UANL-CA-170/TAKE-HOME-LABS/pcb_src/2 FDI-UI-&-PLANTS/M1/documents.pdf

A | A
B | B

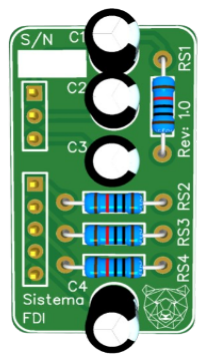
[picture p2: figure]
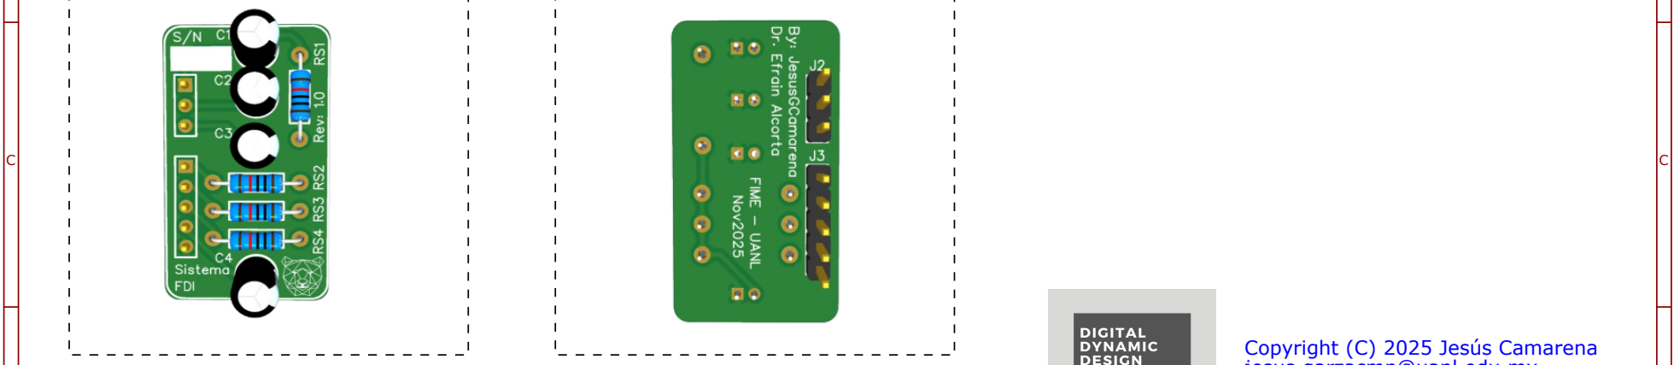
[picture p3: figure]
Copyright (C) 2025 Jesús Camarena

D | D

1

2

3

4

5

TITLE:
COVER PAGE | REV: 1.0
Date: | 15/11/25 Sheet: 1/7
| Drawn By: JesusGCamarena

Company: UANL - FIME

# Sistema FDI

COVER PAGE | DATE: 15/11/2025 V1.0

jesus.garzacmn@uanl.edu.mx Este documento es Open Hardware Licencia: CERN-OHL-S
https://cern-ohl.web.cern.ch/home

3.

2.

# 1. COVER PAGE

# Page Index

4.
MAIN | 5.
LAYOUT | 6.

# MECHANICAL

9.

8.

# 7. REVISION HISTORY

IndexPage | IndexPage

WARNING NOTE:
Example text for a critical design note

LAYOUT NOTE:
Example text for a informational layout guidelines note

Example text for a cautionary design note

CAUTION NOTE:

Example text for a informational design note

INFO NOTE:

TOP PCB VIEW | BOTTOM PCB VIEW 3D MODEL

# PANELIZE BOARD

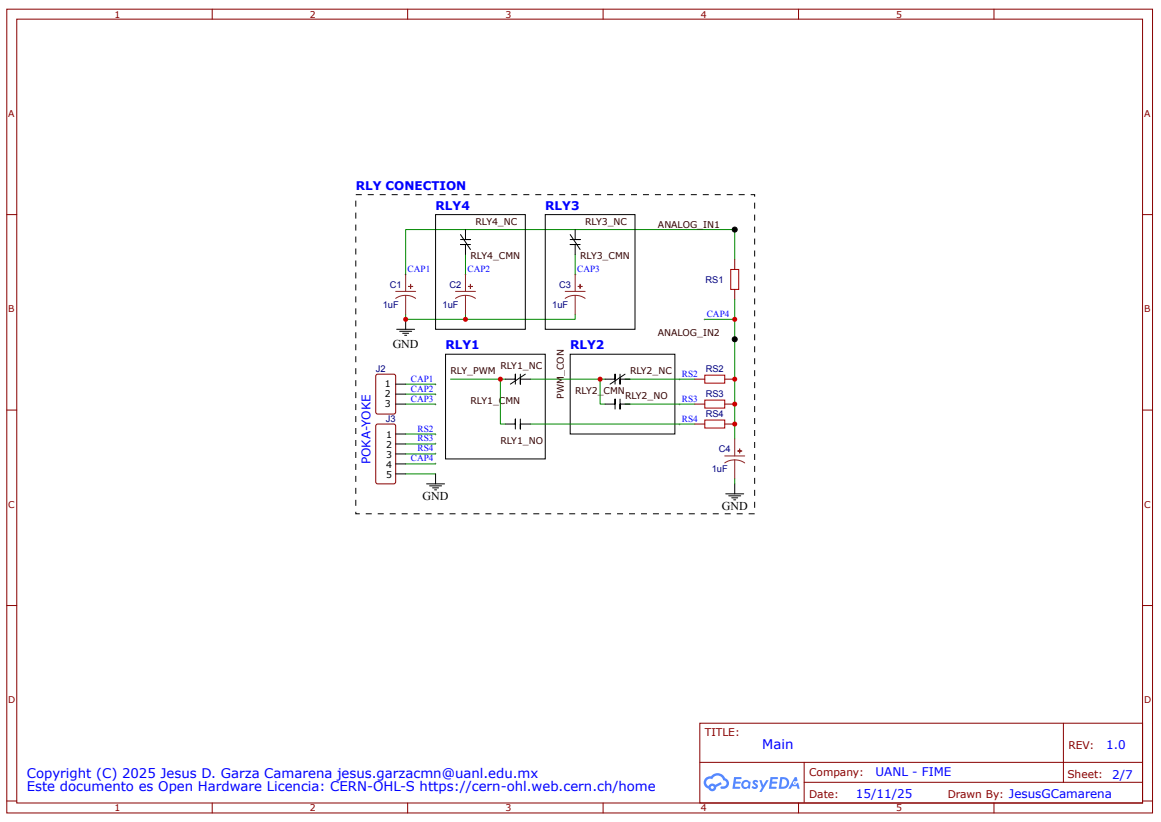
[picture p4: page 2]
TITLE:; Main; REV: 1.0; Date:; Sheet: 2/7; RLY4_NC; RLY4_CMN; RLY3_CMN; RLY3_NC; RLY2_NC; RLY2_CMNRLY2_NO; RLY1_NO; RLY1_NC; RLY1_CMN; CAP2; CAP3; CAP1; GND; CAP4; RLY CONECTION; RLY4; RLY3; RLY1; RLY2; RLY_PWM; PWM_CON; ANALOG_IN2; ANALOG_IN1; POKA-YOKE

Copyright (C) 2025 Jesus D. Garza Camarena jesus.garzacmn@uanl.edu.mx
Este documento es Open Hardware Licencia: CERN-OHL-S https://cern-ohl.web.cern.ch/home

Company: UANL - FIME

Drawn By: JesusGCamarena

# LAYOUT

TOP COPPER | BOTTOM VIEW

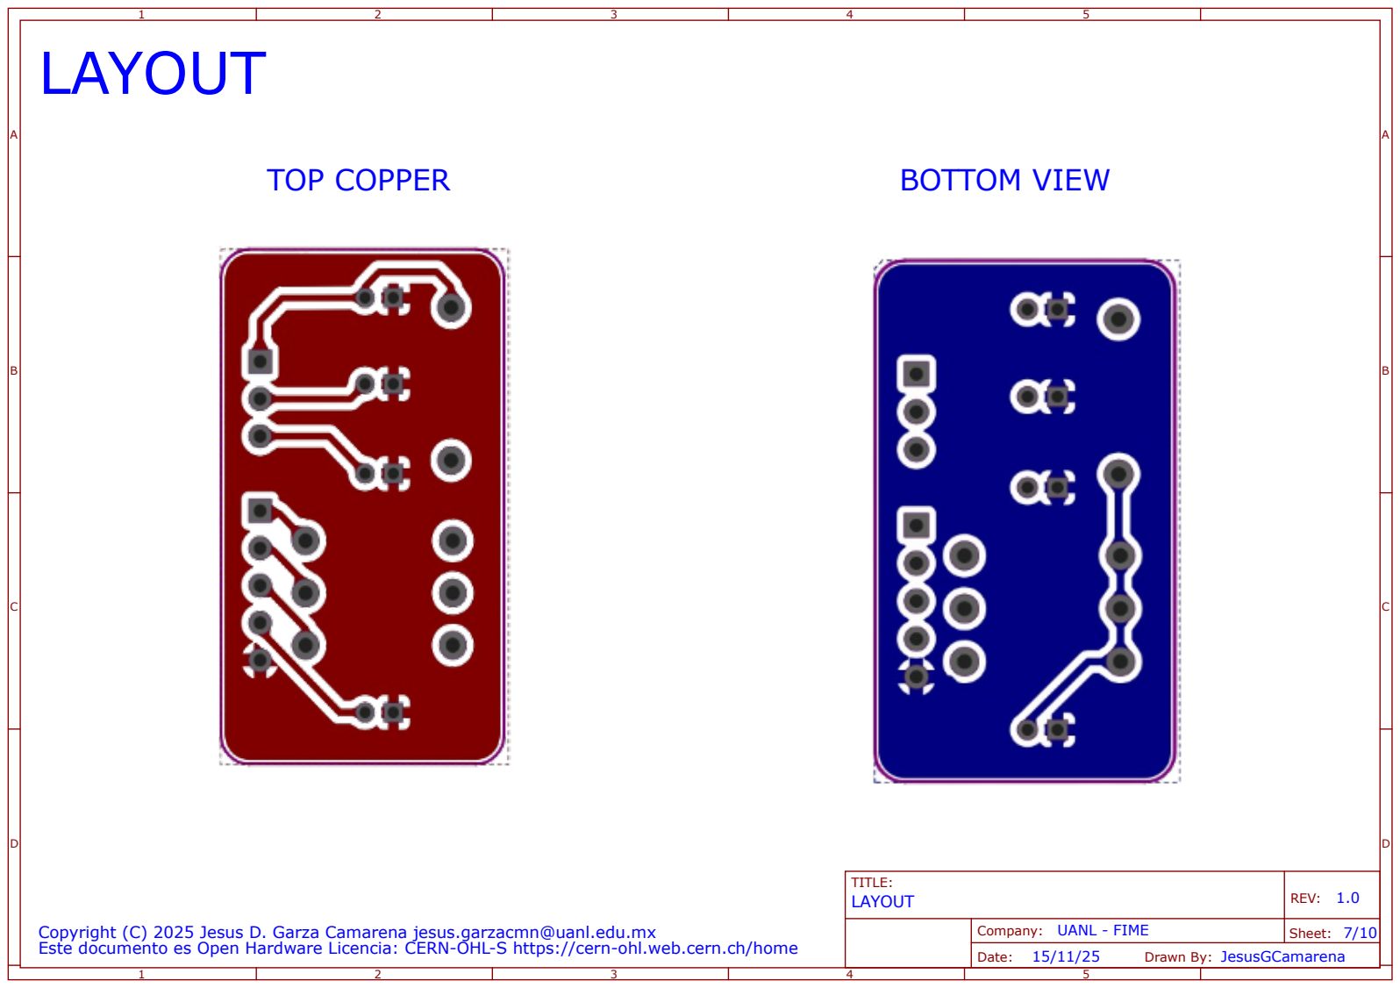
[picture p5: page 3]

A | A
B | B
C | C
D | D

1

2

3

4

5

TITLE:
LAYOUT | REV: 1.0

Date:

Sheet: 7/10
Drawn By:

Company: UANL - FIME
Copyright (C) 2025 Jesus D. Garza Camarena jesus.garzacmn@uanl.edu.mx
Este documento es Open Hardware Licencia: CERN-OHL-S https://cern-ohl.web.cern.ch/home | 15/11/25 | JesusGCamarena

A | A

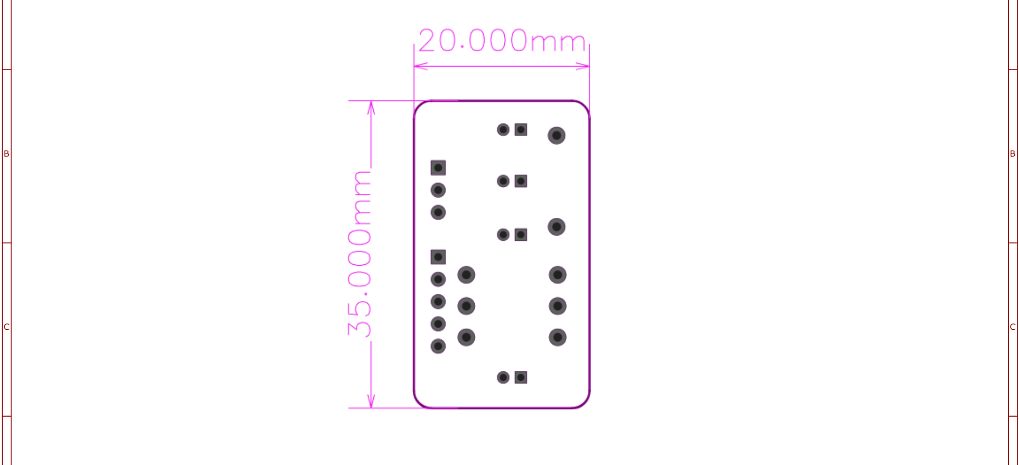
[picture p6: figure]

D | D

1

2

3

4

5

TITLE:
MECHANICAL | REV: 1.0

Date:

Sheet: 8/10
Drawn By:

Company: UANL - FIME

# Mechanical

Copyright (C) 2025 Jesus D. Garza Camarena jesus.garzacmn@uanl.edu.mx
Este documento es Open Hardware Licencia: CERN-OHL-S https://cern-ohl.web.cern.ch/home | 15/11/25 | JesusGCamarena

# PANELIZE BOARD

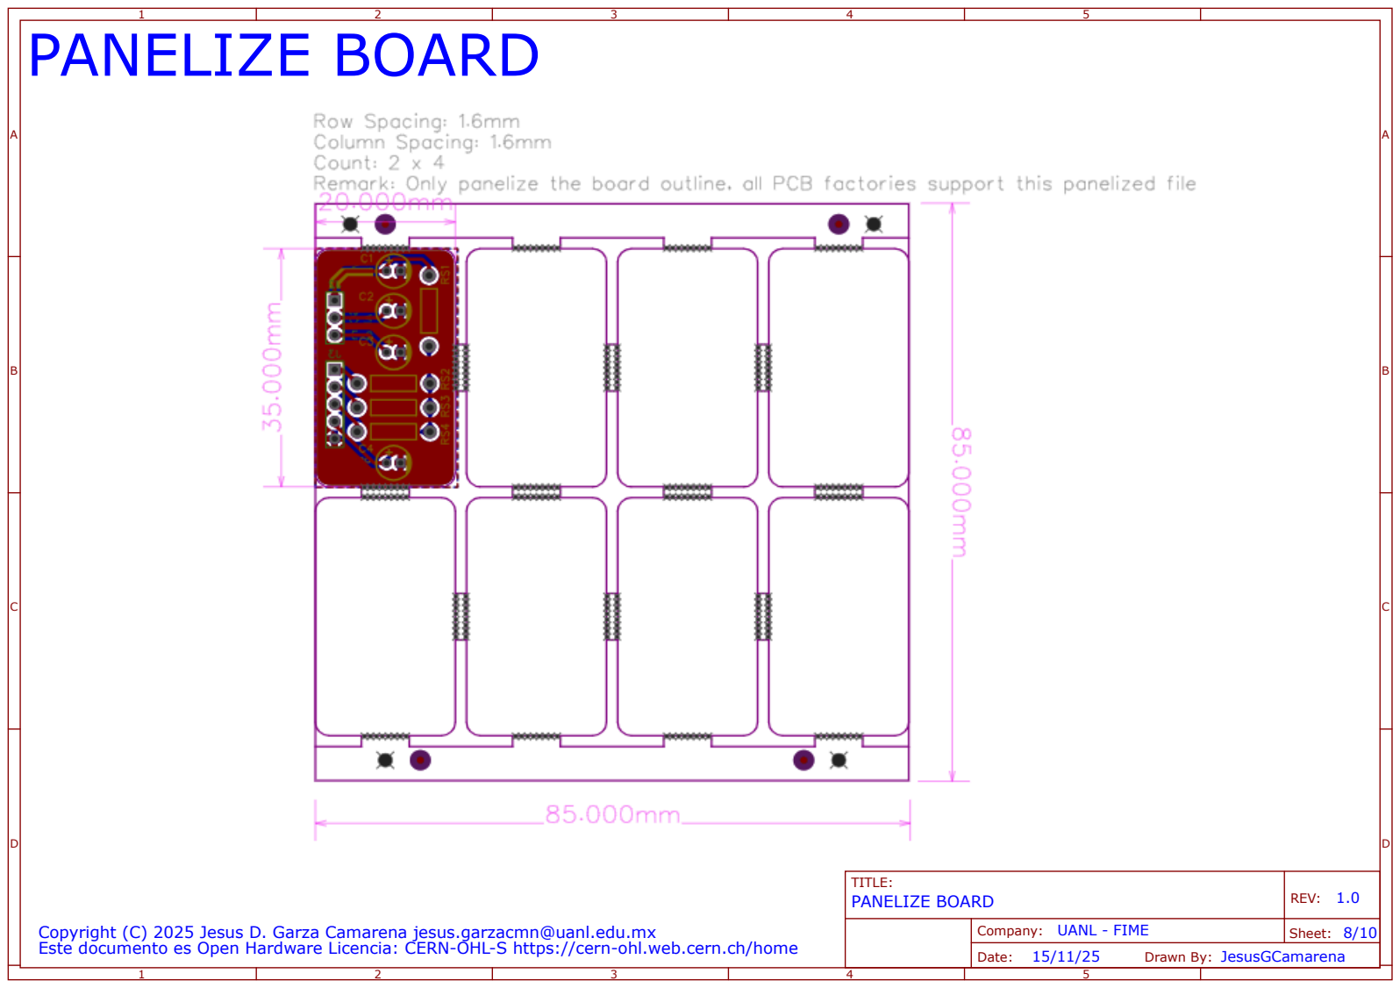
[picture p7: page 5]

A | A
B | B
C | C
D | D

1

2

3

4

5

TITLE:
PANELIZE BOARD | REV: 1.0

Date:

Sheet: 8/10
Drawn By:

Company: UANL - FIME
Copyright (C) 2025 Jesus D. Garza Camarena jesus.garzacmn@uanl.edu.mx
Este documento es Open Hardware Licencia: CERN-OHL-S https://cern-ohl.web.cern.ch/home | 15/11/25 | JesusGCamarena

# 3D MODEL

TOP PCB VIEW | BOTTOM PCB VIEW

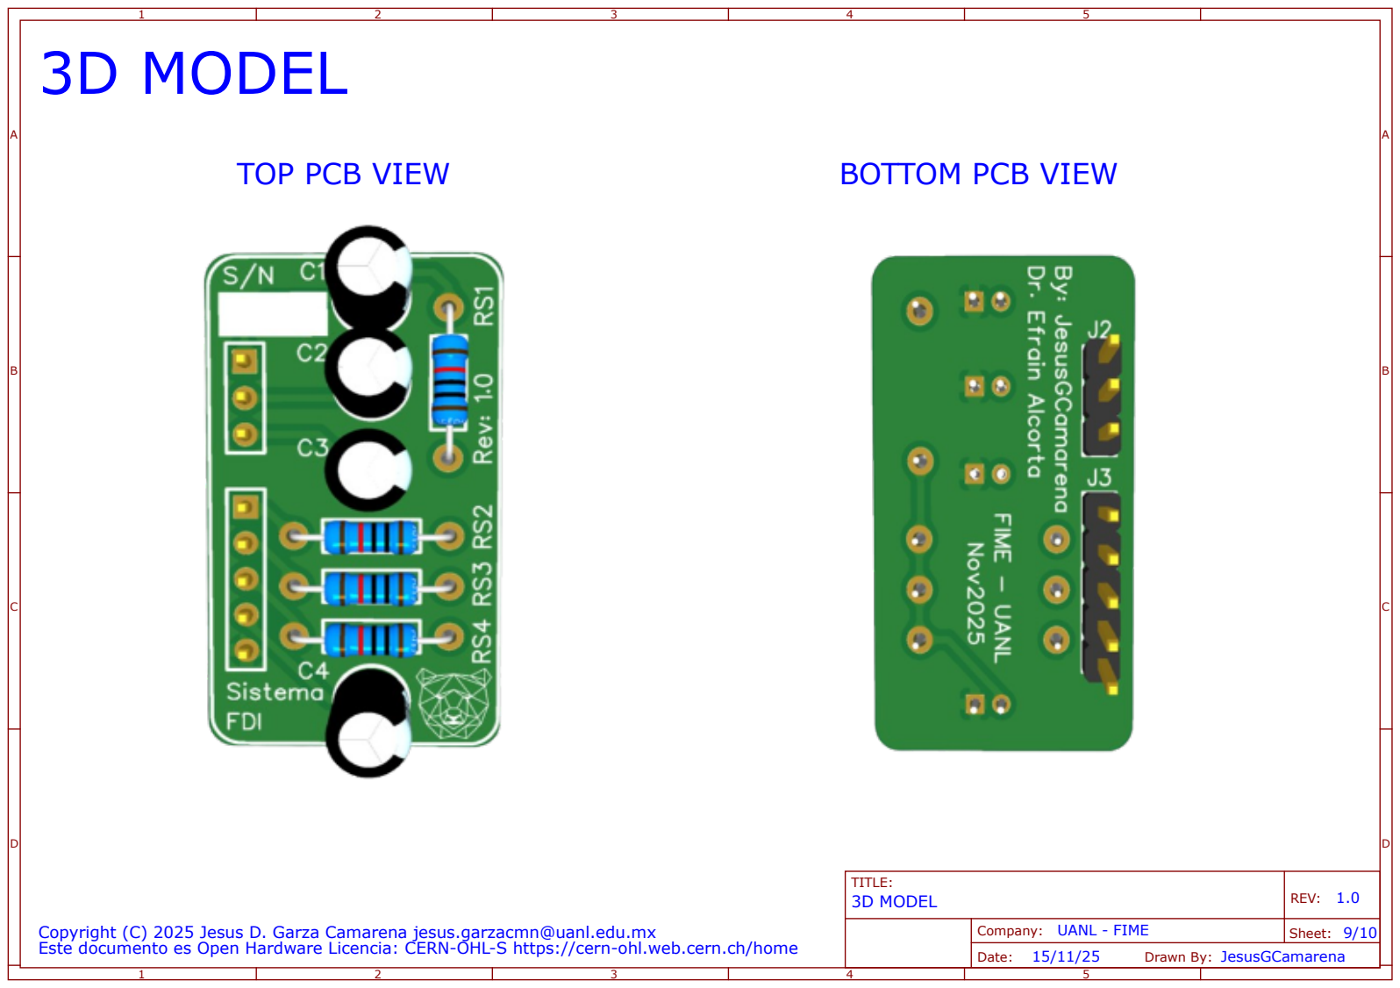
[picture p8: page 6]

A | A
B | B
C | C
D | D

1

2

3

4

5

TITLE:
3D MODEL | REV: 1.0

Date:

Sheet: 9/10
Drawn By:

Company: UANL - FIME
Copyright (C) 2025 Jesus D. Garza Camarena jesus.garzacmn@uanl.edu.mx
Este documento es Open Hardware Licencia: CERN-OHL-S https://cern-ohl.web.cern.ch/home | 15/11/25 | JesusGCamarena

A | A
B | B
C | C
D | D

1

2

3

4

5

TITLE:
REVISION HISTORY | REV: 1.0

Date:

Sheet:10/10
Drawn By:

Company: UANL - FIME

# N° Revision/Issue: Date:

# REVISION HISTORY

Copyright (C) 2025 Jesus D. Garza Camarena jesus.garzacmn@uanl.edu.mx
Este documento es Open Hardware Licencia: CERN-OHL-S https://cern-ohl.web.cern.ch/home
Initial Design | 11/11/25
15/11/25 | JesusGCamarena
