UANL-CA-170/TAKE-HOME-LABS/pcb_src/2 FDI-UI-&-PLANTS/UI/documents.pdf

A | A
B | B

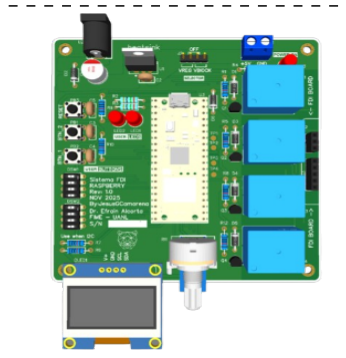
[picture p9: figure]
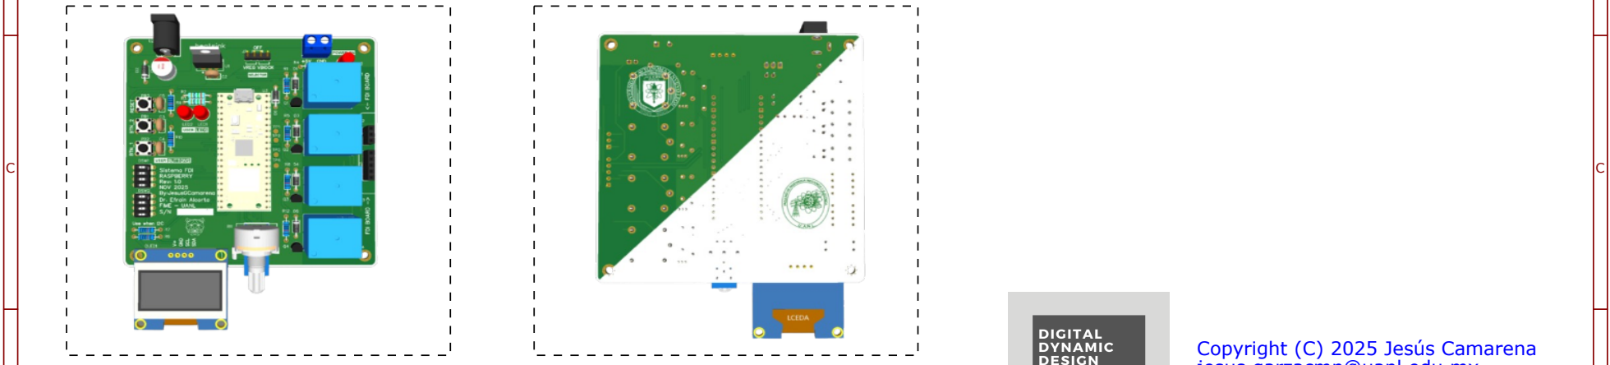
[picture p10: figure]
Copyright (C) 2025 Jesús Camarena

D | D

1

2

3

4

5

TITLE:
COVER PAGE | REV: 1.1
Date: | 15/11/25 Sheet: 1/10
| Drawn By: JesusGCamarena

Company: UANL - FIME

# Sistema Embebido RaspBerry

COVER PAGE | DATE: 15/11/2025 V1.0

jesus.garzacmn@uanl.edu.mx Este documento es Open Hardware Licencia: CERN-OHL-S
https://cern-ohl.web.cern.ch/home

3.

2.

1.

# BLOCK DIAGRAM

# COVER PAGE

# PIN LIST

# Page Index

4.
MAIN5.

# LAYOUT

6.

# MECHANICAL

9.

8.

7.

# REVISION HISTORY

IndexPage | IndexPage

WARNING NOTE:
Example text for a critical design note

LAYOUT NOTE:
Example text for a informational layout guidelines note

Example text for a cautionary design note

CAUTION NOTE:

Example text for a informational design note

INFO NOTE:

TOP PCB VIEW | BOTTOM PCB VIEW

10.

# 3D MODEL

# PIN OUT

# ORIGINAL

# BLOCK DIAGRAM

## POWER SOURCE

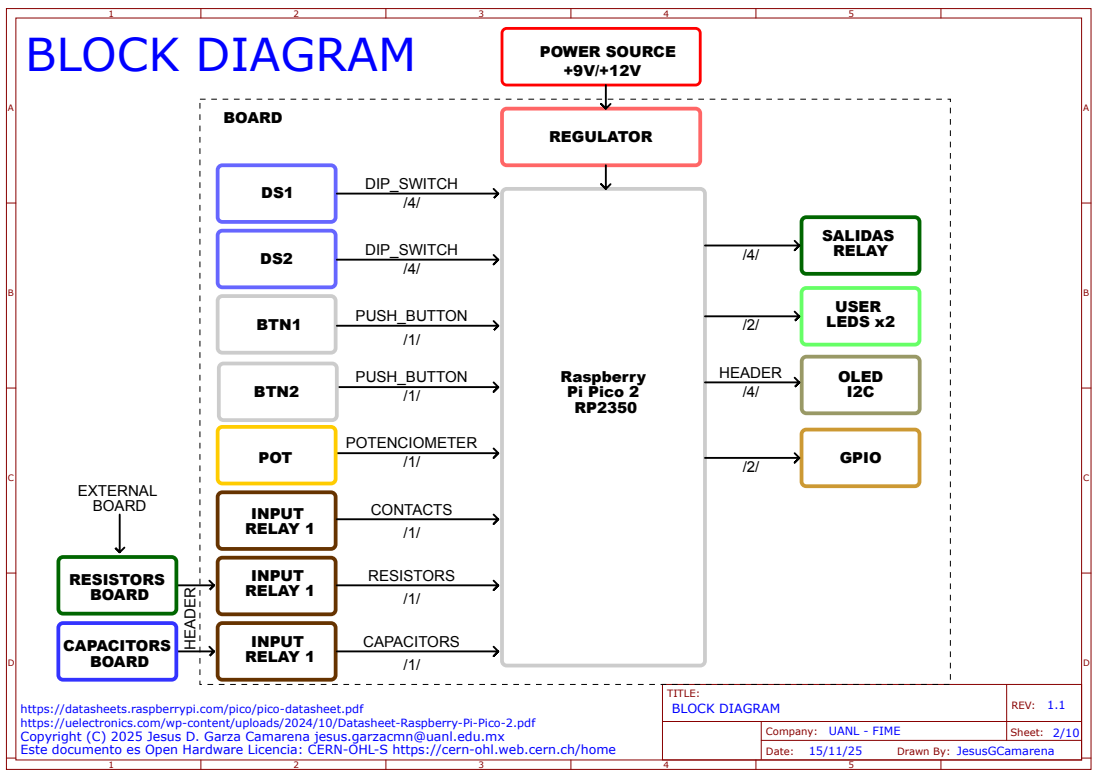
[picture p11: page 2]
TITLE:; BLOCK DIAGRAM; REV: 1.1; Sheet: 2/10; Drawn By:; REGULATOR; SALIDAS RELAY; GPIO; Raspberry Pi Pico 2 RP2350; BOARD; POT; INPUT RELAY 1; DIP_SWITCH; OLED I2C; PUSH_BUTTON; POTENCIOMETER; CONTACTS; HEADER; DIP_SWITCH /4/; BTN1; BTN2; PUSH_BUTTON /1/; USER; LEDS x2; INPUT; RESISTORS; RELAY 1; CAPACITORS; RESISTORS BOARD; CAPACITORS BOARD; EXTERNAL BOARD; JesusGCamarena

https://datasheets.raspberrypi.com/pico/pico-datasheet.pdf
https://uelectronics.com/wp-content/uploads/2024/10/Datasheet-Raspberry-Pi-Pico-2.pdf
Copyright (C) 2025 Jesus D. Garza Camarena jesus.garzacmn@uanl.edu.mx
Este documento es Open Hardware Licencia: CERN-OHL-S https://cern-ohl.web.cern.ch/home

Company: UANL - FIME
Date:

## RLY1

## RLY2

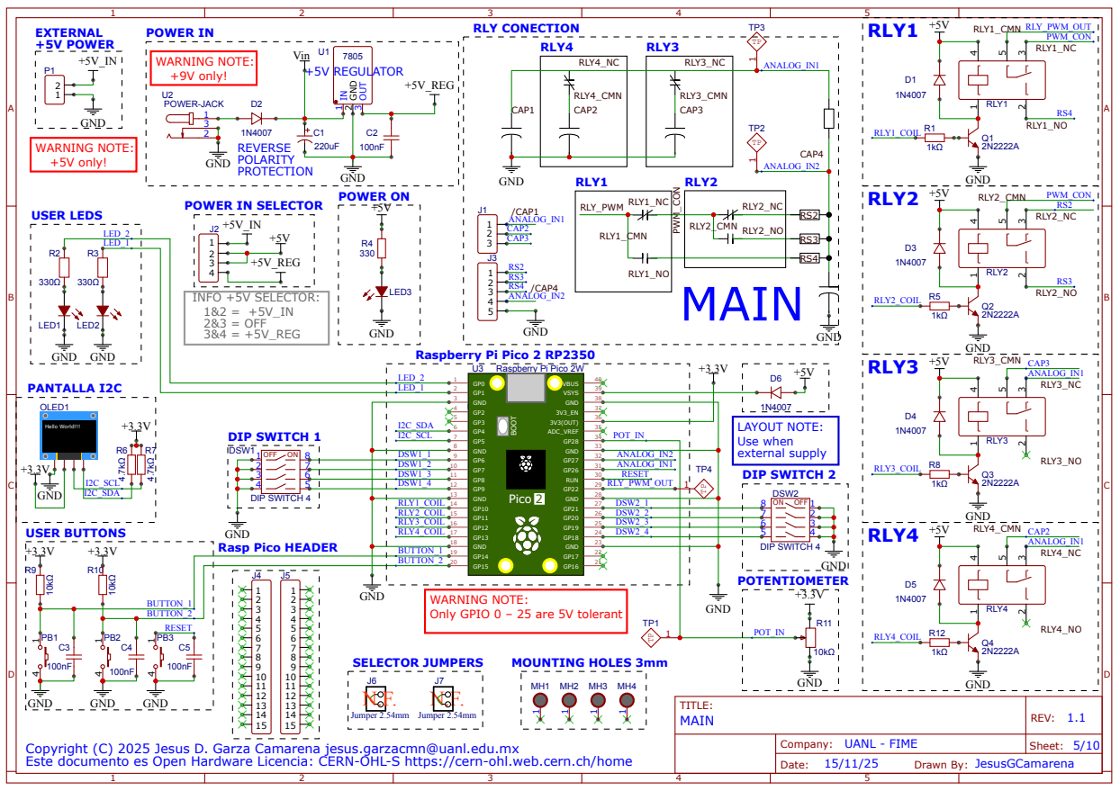
[picture p12: page 3]

WARNING NOTE:
Only GPIO 0 – 25 are 5V tolerant

Copyright (C) 2025 Jesus D. Garza Camarena jesus.garzacmn@uanl.edu.mx
Este documento es Open Hardware Licencia: CERN-OHL-S https://cern-ohl.web.cern.ch/home

# ORIGINAL LAYOUT

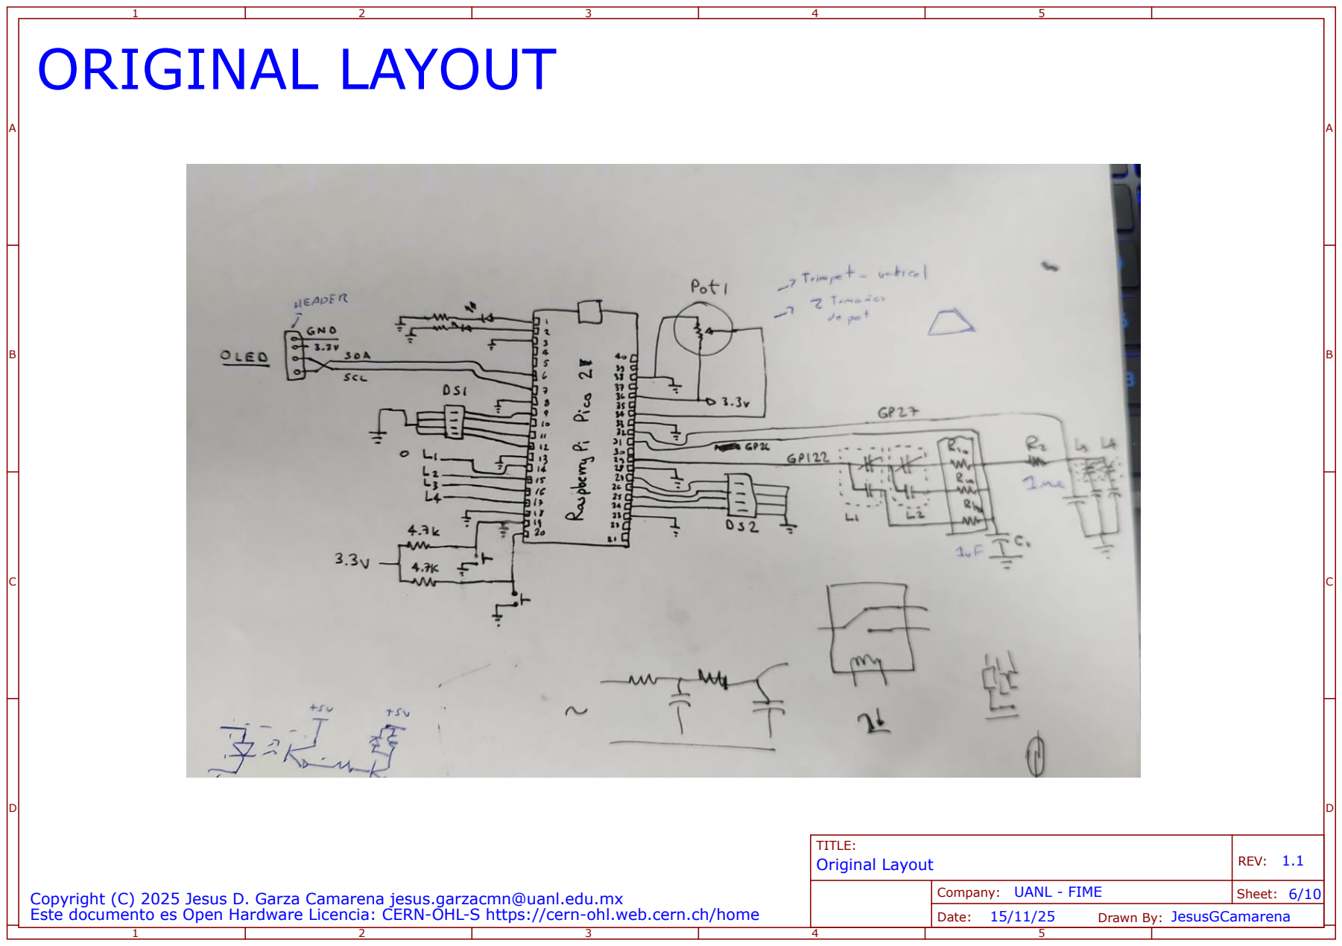
[picture p13: page 4]

A | A
B | B
C | C
D | D

1

2

3

4

5

TITLE:
Original Layout | REV: 1.1

Date:

Sheet: 6/10
Drawn By:

Company: UANL - FIME
Copyright (C) 2025 Jesus D. Garza Camarena jesus.garzacmn@uanl.edu.mx
Este documento es Open Hardware Licencia: CERN-OHL-S https://cern-ohl.web.cern.ch/home | 15/11/25 | JesusGCamarena

A | A
B | B
C | C
D | D

1

2

3

4

5

TITLE:
REVISION HISTORY | REV: 1.1

Date:

Sheet:10/10
Drawn By:

Company: UANL - FIME

# N° Revision/Issue: Date:

# REVISION HISTORY

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

Conexiones de la fuente VSYS y VBUS Conexiones RLY3 y RLY4
Pines que soportan +5V
Initial Design | 04/07/25
| 28/10/25 28/10/25
| 28/10/25
First Relase | 15/11/25
15/11/25 | JesusGCamarena

# LAYOUT

TOP COPPER | BOTTOM VIEW

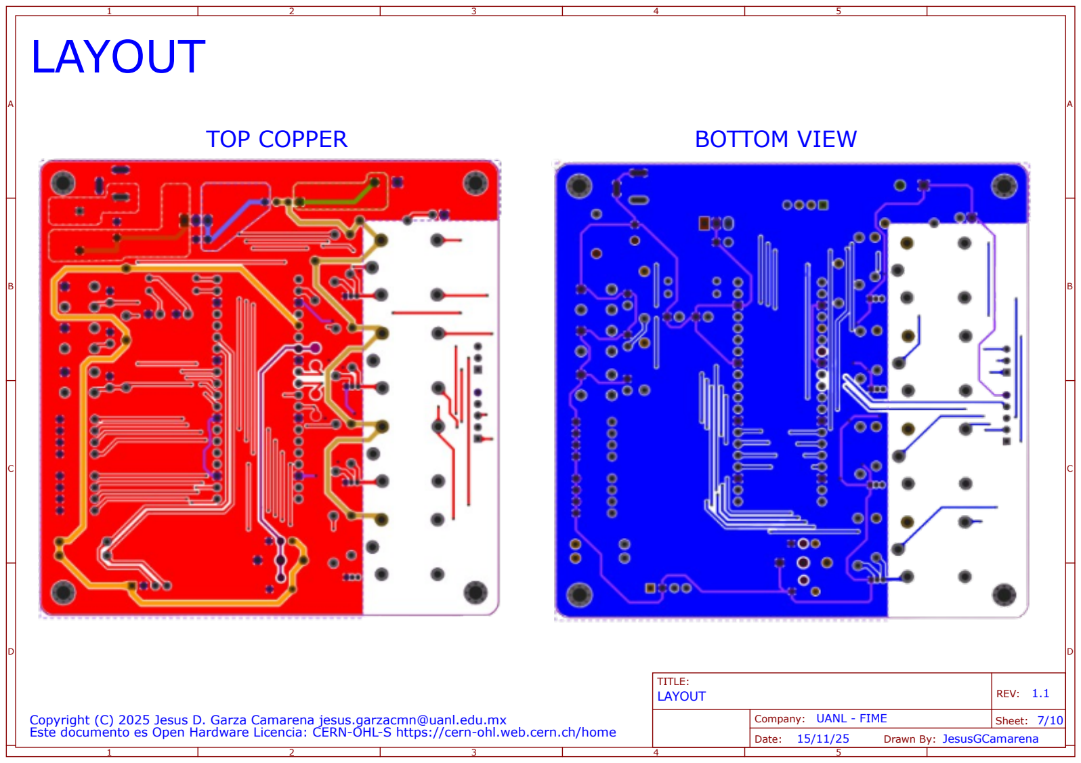
[picture p14: page 6]

A | A
B | B
C | C
D | D

1

2

3

4

5

TITLE:
LAYOUT | REV: 1.1

Date:

Sheet: 7/10
Drawn By:

Company: UANL - FIME
Copyright (C) 2025 Jesus D. Garza Camarena jesus.garzacmn@uanl.edu.mx
Este documento es Open Hardware Licencia: CERN-OHL-S https://cern-ohl.web.cern.ch/home | 15/11/25 | JesusGCamarena

# PIN LIST

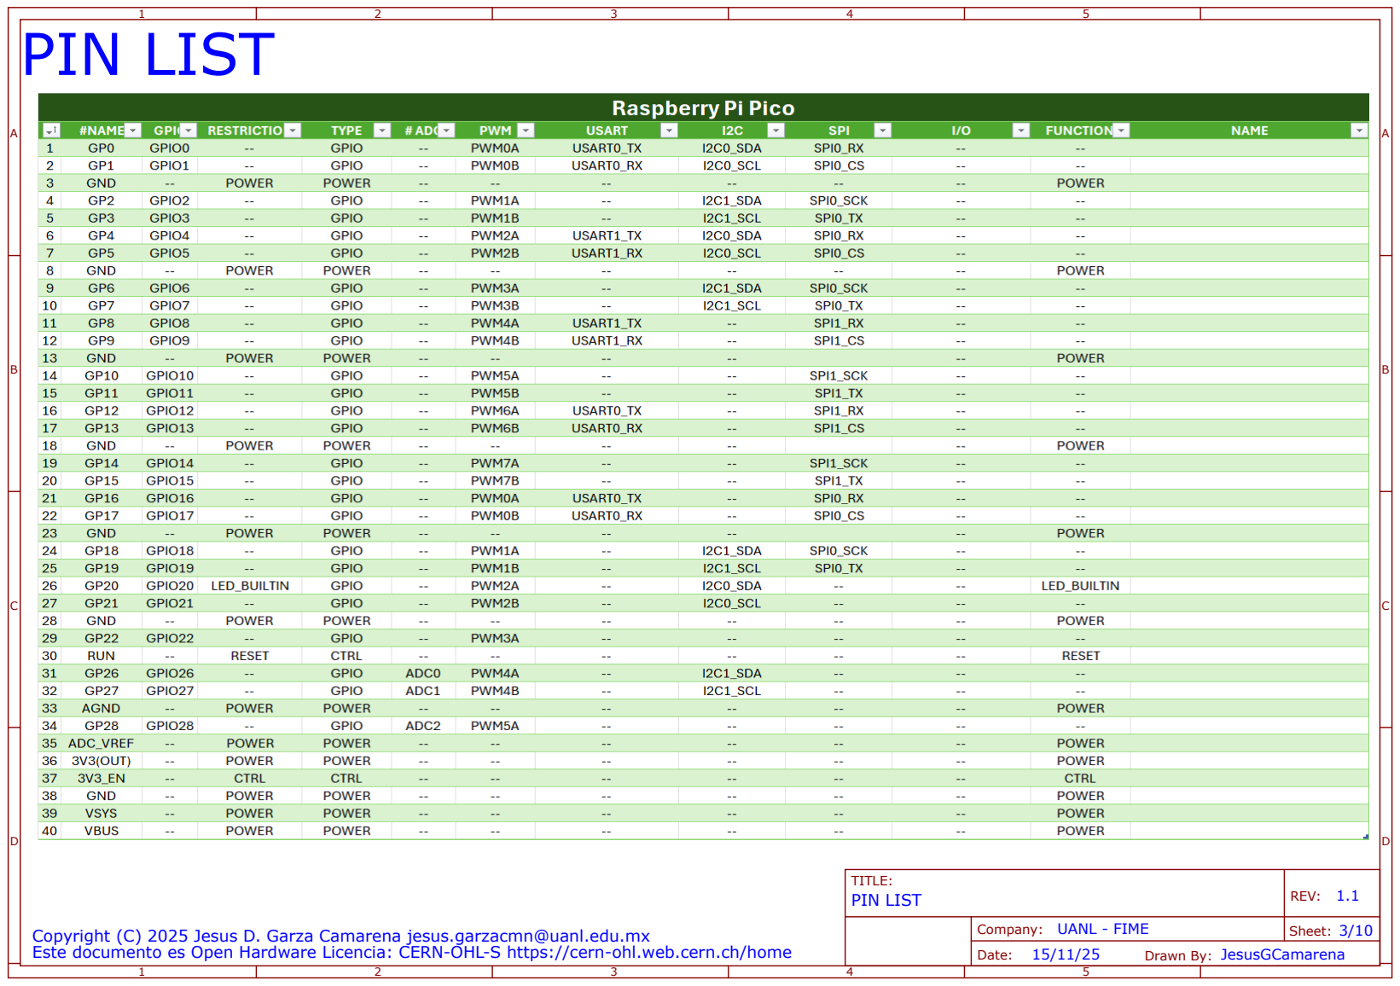
[picture p15: page 7]

A | A
B | B
C | C
D | D

1

2

3

4

5

TITLE:
PIN LIST | REV: 1.1

Date:

Sheet: 3/10
Drawn By:

Company: UANL - FIME
Copyright (C) 2025 Jesus D. Garza Camarena jesus.garzacmn@uanl.edu.mx
Este documento es Open Hardware Licencia: CERN-OHL-S https://cern-ohl.web.cern.ch/home | 15/11/25 | JesusGCamarena

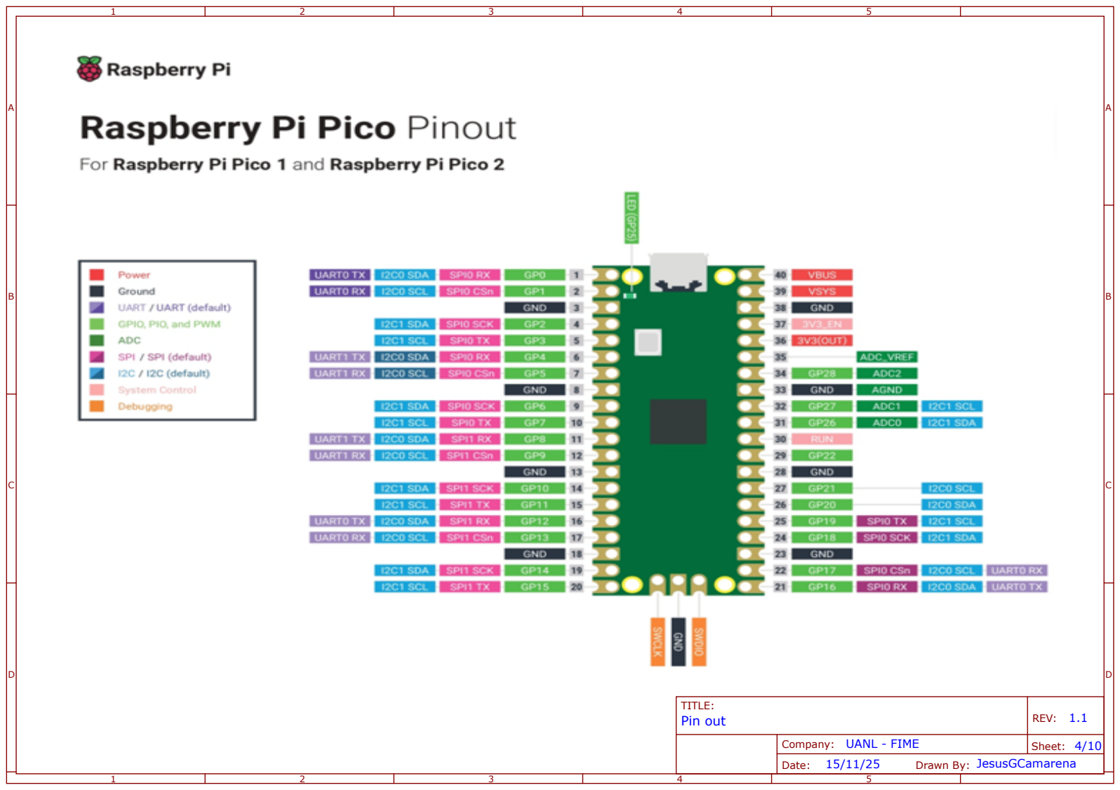
[picture p16: page 8]

A | A
B | B
C | C
D | D

1

2

3

4

5

TITLE:
Pin out | REV: 1.1

Date:

Sheet: 4/10
Drawn By:

Company: UANL - FIME
15/11/25 | JesusGCamarena

# Mechanical

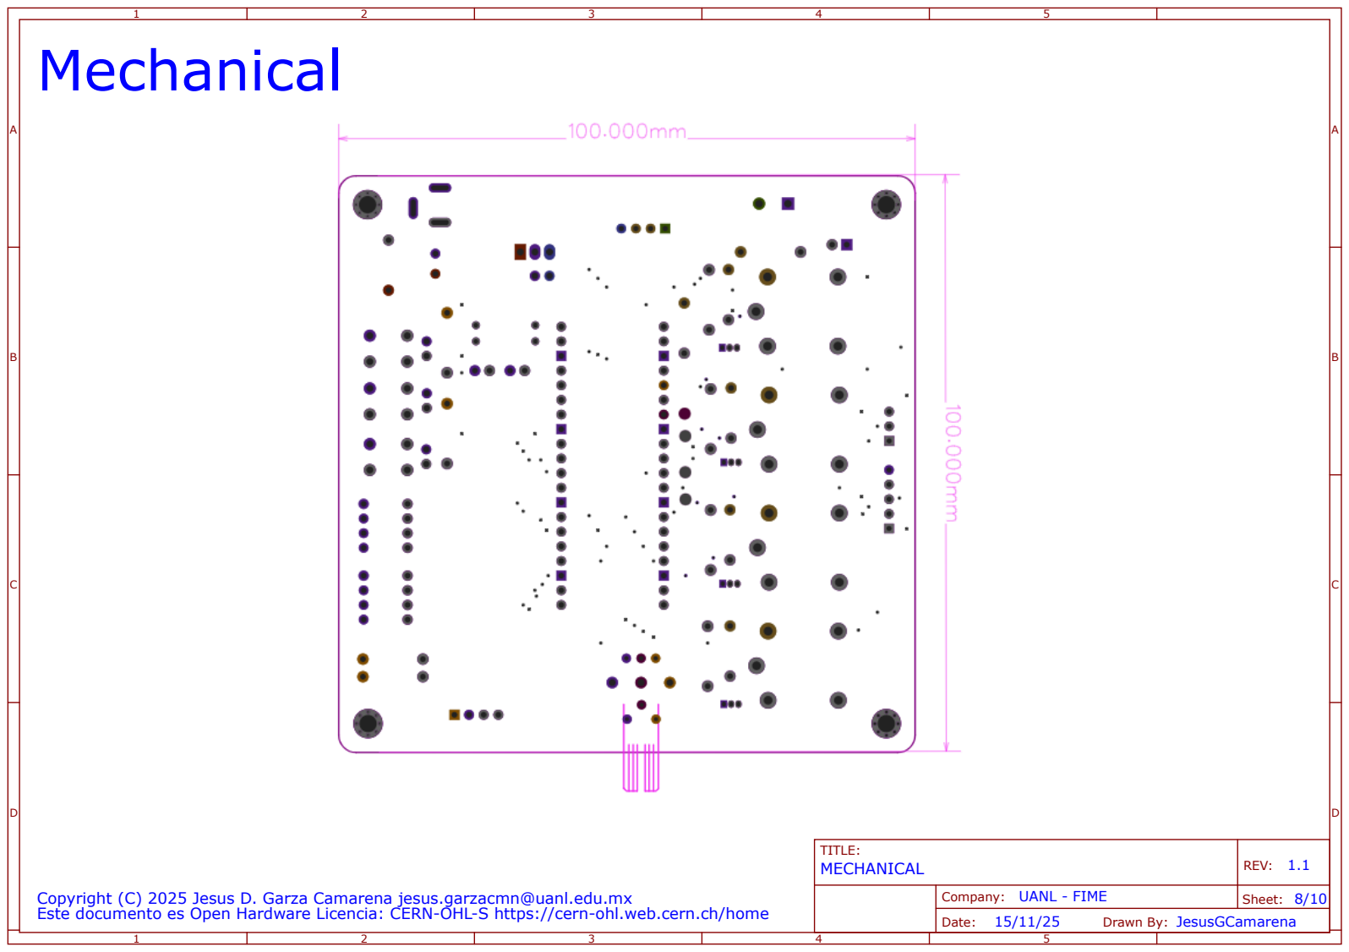
[picture p17: page 9]

A | A
B | B
C | C
D | D

1

2

3

4

5

TITLE:
MECHANICAL | REV: 1.1

Date:

Sheet: 8/10
Drawn By:

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

# 3D MODEL

TOP PCB VIEW | BOTTOM PCB VIEW

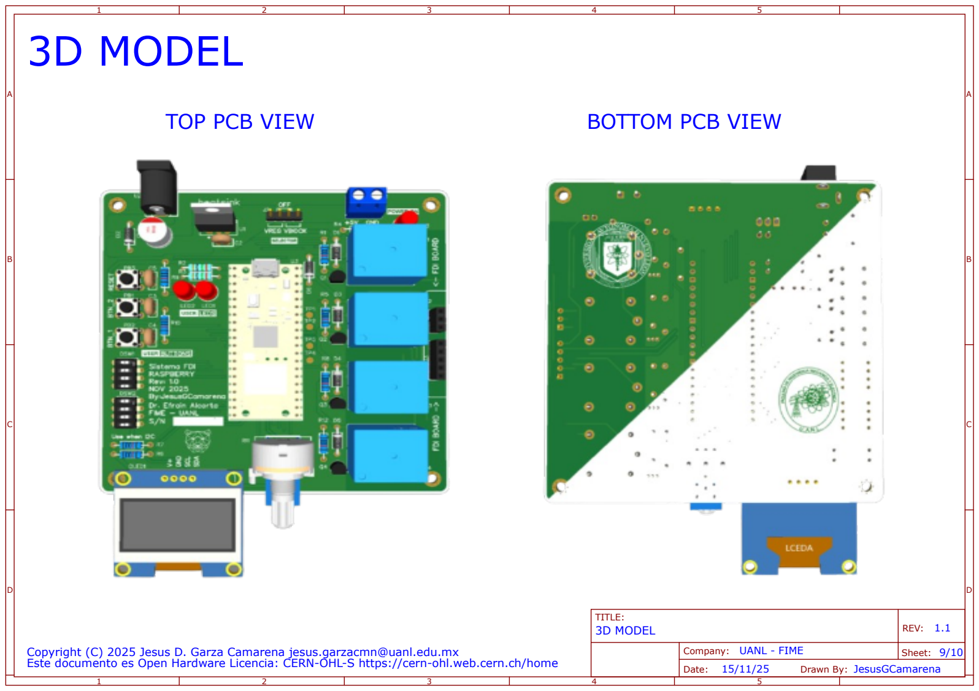
[picture p18: page 10]

A | A
B | B
C | C
D | D

1

2

3

4

5

TITLE:
3D MODEL | REV: 1.1

Date:

Sheet: 9/10
Drawn By:

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
