UANL-CA-170/TAKE-HOME-LABS/pcb_src/2 FDI-UI-&-PLANTS/UI/BOM_RaspBerry_Dr_Efrain_Alcorta-rev-1_2026-05-23.csv

ID | Name | Designator | Footprint | Quantity | Manufacturer Part | Manufacturer | Supplier | Supplier Part | Price
1 | 1-POINT TEST POINT | TP1,TP2,TP3,TP4 | 1-POINT_TEST-POINT | 4
2 | 1N4007 | D6,D2,D1,D3,D4,D5 | DO-41_BD2.4-L4.7-P8.70-D0.9-RD | 6 | 1N4007 | SEMTECH | LCSC | C106903 | 0.02
3 | HDR-M-2.54_1x3 | J1 | HDR-F-2.54_1X3 | 1 |  |  | LCSC | C180248 | 0.214
4 | HDR-M-2.54_1x5 | J3 | HDR-F-2.54_1X5 | 1 |  |  | LCSC | C358687 | 0.032
5 | 330 | R4 | RES-TH_BD2.3-L6.5-P6.9-D0.5 | 1 | CR2W-10K±5%-QT73 | VO(翔胜) | LCSC | C479269 | 0.023
6 | 333-2SURD/S530-A3 | LED3,LED1,LED2 | LED-TH_BD5.9-P2.54-RD_RED | 3 | 333-2SURD/S530-A3 | EVERLIGHT(亿光) | LCSC | C87271 | 0.035
7 | 220uF | C1 | CAP-TH_BD8.0-P3.50-D0.6-FD | 1 | KM227M035F12RR0VH2FP0 | CX(承兴) | LCSC | C2063 | 0.043
8 | 100nF | C2,C3,C4,C5 | CAP-TH_L5.8-W2.4-P2.54-D0.6 | 4 | CC1H104ZA1ED3F5P1100 | Dersonic(德尔创) | LCSC | C2832506 | 0.022
9 | HDR-M-2.54_1x4 | J2 | HDR-M-2.54_1X4 | 1 |  |  | LCSC | C225501 | 0.098
10 | 1kΩ | R5,R8,R12,R1 | RES-TH_BD2.3-L6.5-P6.9-D0.5 | 4 | CR2W-10K±5%-QT73 | VO(翔胜) | LCSC | C479269 | 0.023
11 | 4.7kΩ | R6,R7 | RES-TH_BD2.3-L6.5-P6.9-D0.5 | 2 | CR2W-10K±5%-QT73 | VO(翔胜) | LCSC | C479269 | 0.023
12 | 10kΩ | R9,R10 | RES-TH_BD2.3-L6.5-P6.9-D0.5 | 2 | CR2W-10K±5%-QT73 | VO(翔胜) | LCSC | C479269 | 0.023
13 | 10kΩ | R11 | POT_3_MIX | 1 | RK1631110U1Q | ALPSALPINE(阿尔卑斯阿尔派) | LCSC | C370978 | 1.849
14 | Raspberry Pi Pico 2W | U3 | RASPBERRYPI_PICO2_MODULE | 1
15 | 0.96OLED_4P | OLED1 | 0.96OLED_4P | 1 |  |  | LCSC
16 | DIP SWITCH 4 | DSW1,DSW2 | DIP SWITCH 4 SWITCHES | 2 | DS-4P-BU | DIP | DORABO | C46595748 | 0.299
17 | CONN-TH_2P-P5.00 | P1 | CONN-TH_2P-P5.00 | 1 | MX301-5.0-02P-GN01-Cu-Y-A | MAX | LCSC | C5188424 | 0.103
18 | 2N2222A | Q1,Q2,Q3,Q4 | TO-92-3_L4.5-W3.5-P1.27-L | 4 | 2N2222A | HXY MOSFET(华轩阳电子) | LCSC | C20616319 | 0.021
19 | SRD-05VDC-SL-C | RLY1,RLY2,RLY3,RLY4 | RELAY-TH_SRD-XXVDC-XL-C | 4 | SRD-05VDC-SL-C | 松乐 | LCSC | C35449 | 0.486
20 | 7805 | U1 | TO-220-3_L10.0-W4.5-P2.54-L | 1 | 7805 | BLUE ROCKET(蓝箭) | LCSC | C305416 | 0.224
21 | 330Ω | R2,R3 | RES-TH_BD2.4-L6.3-P10.30-D0.6 | 2 | RD 1/4W 330R J T/B A1 | Tyohm(幸亚电阻) | LCSC | C433729 | 0.009
22 | POWER-JACK | U2 | DC-IN-TH_POWER-JACK | 1 | POWER-JACK | 索峰 | LCSC | C9900001795
23 | TS-1102-5016 | PB1,PB2,PB3 | SW-TH_4P-L6.0-W6.0-P3.90-LS6.5 | 3 | TS-1102-5016 | SOFNG(硕方) | LCSC | C111609 | 0.041
