UANL-CA-170/TAKE-HOME-LABS/pcb_src/1 THL-UI-&-PLANTS/UI/bae712743d884533951a2634584a3abf.csv

ID | Name | Designator | Footprint | Quantity | Manufacturer Part | Manufacturer | Supplier | Supplier Part | Price | link | Contributor | 3DModel | JLCPCB Part Class | Resistance (Ohms)
1 | PZ254V-11-10P | H1 | HDR-TH_10P-P2.54-V-M | 1 | PZ254V-11-10P | XFCN(兴飞) | LCSC | C492409 |  | https://item.szlcsc.com/502965.html | LCSC | HDR2.54-M-LI-1X10P | Extended Part
2 | PZ254V-11-08P | H2,H4 | HDR-TH_8P-P2.54-V-M | 2 | PZ254V-11-08P | XFCN(兴飞) | LCSC | C492407 |  | https://item.szlcsc.com/502963.html | LCSC | HDR-TH_8P-P2.54-V-M | Extended Part
3 | PZ254V-11-06P | H3 | HDR-TH_6P-P2.54-V-M | 1 | PZ254V-11-06P | XFCN(兴飞) | LCSC | C492405 |  | https://item.szlcsc.com/502961.html | LCSC | HDR-TH_6P-P2.54-M-LI-1X6P | Extended Part
4 | 2.54-1*4P母 | H5,H6,H7 | HDR-TH_4P-P2.54-V-F | 3 | 2.54-1*4P母 | BOOMELE(博穆精密) | LCSC | C2718488 |  | https://item.szlcsc.com/523021.html | LCSC | HDR-TH_4P-P2.54-F-LI-1X4P | Extended Part
5 | E6Q0603QBAC1UDA | LED9,LED10,LED11 | LED-SMD_L1.6-W0.8-RD-BLUE | 3 | E6Q0603QBAC1UDA | ekinglux(亿晶源) | LCSC | C375575 |  | https://item.szlcsc.com/270299.html | LCSC | LED-SMD_2P-L1.6-W0.8-H0.6 | Extended Part
6 | 10kΩ | POT0 | RES-TH_RK09K113004U | 1 | RK09K113004U | ALPSALPINE(阿尔卑斯阿尔派) | LCSC | C202382 |  | https://item.szlcsc.com/203582.html | LCSC | RES-TH_RK09K113004U | Extended Part | 10K
7 | 4.7k | R4,R7,R8,R20,R30 | R0603 | 5 | RMC08054.7K1%N | Tyohm | LCSC | C269746 |  | https://www.mouser.in/datasheet/2/447/PYu_RT_1_to_0_01_RoHS_L_11-1669912.pdf | LCEDA_Lib | R0603
8 | 330Ω | R9,R10,R11 | R0805 | 3 | 0805W8F3300T5E | UNI-ROYAL(厚声) | LCSC | C17630 |  | https://item.szlcsc.com/142685.html | lcsc | R0805_L2.0-W1.3-H0.6 | Basic Part
9 | KH-6X6X5H-TJ | RESET,SW2,SW3 | SW-TH_4P-L6.0-W6.0-P4.50-LS6.5 | 3 | KH-6X6X5H-TJ | kinghelm(金航标) | LCSC | C2837515 |  | https://item.szlcsc.com/14483.html | LCSC | SW-TH_4P-L6.0-W6.0-H5.0-LS6.5-P4.50 | Extended Part
10 | DIP-SWITCH | SW478 | SW-TH_6P-L9.2-W9.9-P2.54-LS7.6 | 1 | DS-03BLP | XKB Connectivity(中国星坤) | LCSC | C692501 |  | https://item.szlcsc.com/product/jpg_300162_0.html | LCSC | SW-TH_6P-L7.6-W6.2-H4.2-P2.54-LS7.6 | Extended Part
11 | ZX-PZ2.54-2-3PZZ | U1 | HDR-TH_6P-P2.54-V-M-R2-C3-S2.54-1 | 1 | ZX-PZ2.54-2-3PZZ | Megastar(兆星) | LCSC | C7501274 |  | https://lcsc.com/product-detail/Female-Header_Made-in-China-Made-in-China-Made-in-China-Made-in-Cina-2-54mm-2x3-Female-header-Bagged-RoHS_C47552.html | lcsc | HDR2.54-M-LI-2x3P | Extended Part
