UANL-CA-170/TAKE-HOME-LABS/pcb_src/2 FDI-UI-&-PLANTS/M1/BOM_Sistema_FDI_2026-05-23.csv

ID | Name | Designator | Footprint | Quantity | Manufacturer Part | Manufacturer | Supplier | Supplier Part | Price
1 | HDR-M-2.54_1x3 | J2 | HDR-M-2.54_1X3 | 1 |  |  | LCSC | C180248 | 0.214
2 | HDR-M-2.54_1x5 | J3 | HDR-M-2.54_1X5 | 1 |  |  | LCSC | C358687 | 0.032
3 | 10kΩ | RS1,RS2,RS3,RS4 | RES-TH_BD2.3-L6.5-P6.9-D0.5 | 4 | CR2W-10K±5%-QT73 | VO(翔胜) | LCSC | C479269 | 0.023
4 | 1uF | C1,C2,C3,C4 | CAP-D5.0×F2.0 | 4
