UANL-CA-170/TAKE-HOME-LABS/(commit log)

2026-05-22 add UI and plants M1 to M6 gerbers
    [bae712743d884533951a2634584a3abf.csv]
2026-05-23 add FDI PCB gerber files and documentation
    [BOM_RaspBerry_Dr_Efrain_Alcorta-rev-1_2026-05-23.csv, BOM_Sistema_FDI_2026-05-23.csv, PickAndPlace_PCB-copy_2026-05-23.csv, PickAndPlace_PCB_Sistema_FDI_2026-05-23.csv]
